Marcin214/MiniOscilloscope/(list of files, drawings)

Other design files:
hardware/pcb_project/0SC_praca_mgr.PcbDoc
hardware/pcb_project/0SC_praca_mgr.PrjPcb
hardware/pcb_project/0SC_praca_mgr.SchDoc
