Marcin214/MiniOscilloscope/tests/functional_test/spi_mcp23s09_and_mcp4921/command_decoder.h

#define MAX_TOKEN_NR 						2        	//maksymalna dopuszczalna ilosc tokenów
#define MAX_KEYWORD_NR 					4         // maksymalna liczba komend
#define MAX_KEYWORD_STRING_LTH 20 	      // maksymalna dlugosc komendy


typedef enum { TOKEN, DELIMITER} TokenStatus;
typedef enum { KEYWORD, NUMBER, STRING} TokenType;
typedef enum { PORTSET, MCP_PORT_RD, DACSET, ID} KeywordCode;

typedef struct{
	KeywordCode eCode;
	char cString[MAX_KEYWORD_STRING_LTH + 1];
}Keyword;

typedef union{
	KeywordCode eKeyword; 			// jezeli KEYWORD
	unsigned int uiNumber;      // jezeli NUMBER
	char * pcString;            // jezeli STRING
}TokenValue;
	
typedef struct{
	TokenType eType;    				// KEYWORD, NUMBER, STRING
	TokenValue uValue; 					// enum, unsigned int, char*
}Token;


/*----------------------------------------
		   Dekodowanie komunikatów
 *----------------------------------------*/
unsigned char ucFindTokensInString (char *pcString);
//Result eSringToKeyword(char pcStr[], KeywordCode *peKeywordCode);
void DecodeTokens(void);
void DecodeMsg(char *cStr);
